Mutronics/nes2wii/wires.txt

зел - GND
бел - SCL
син - SDA
крас - VCC
