Mutronics/nes2wii/(list of files, drawings)

Other design files:
nes2wii.lay6
