Mutronics/nes2wii/nes2wii.sch

## KiCad design nes2wii.sch (2021-04-27)

Schematic: nes2wii.sch

Parts:
20MHz: CRYSTAL
C1, C2: 18pF
D1: RED_LED
D2: GREEN_LED
P1: WIIMOTE
P2: NES_CONTROLLER
P3: SNES_CONTROLLER
P4: N64_CONTROLLER
P5: SMD_CONTROLLER
P6: DUALSHOCK
R1: 1K
R2, R3: 100

Notes on the sheet:
NES2Wii
N64 CONTROLLER
SNES CONTROLLER
NES CONTROLLER
WIIMOTE CONNECTOR
SMD/GENESIS CONTROLLER
